sharanjeetsinghmago/LowPowerNFCBasedPhoneCover/Datasheets/NFC/OM5569_322E.png

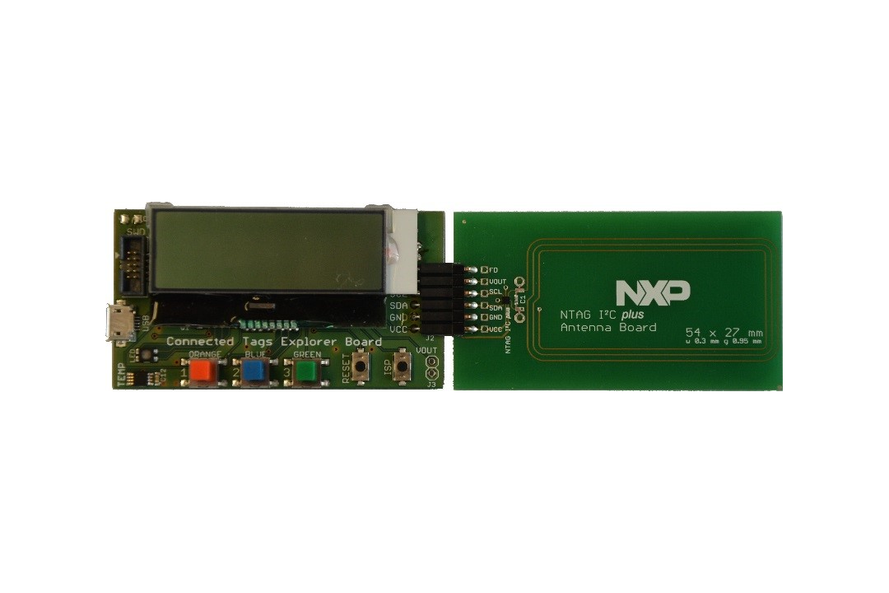
Datasheets/NFC/OM5569_322E.png
