sharanjeetsinghmago/LowPowerNFCBasedPhoneCover/phone_cover_pcb_files/DFM_Result.pdf

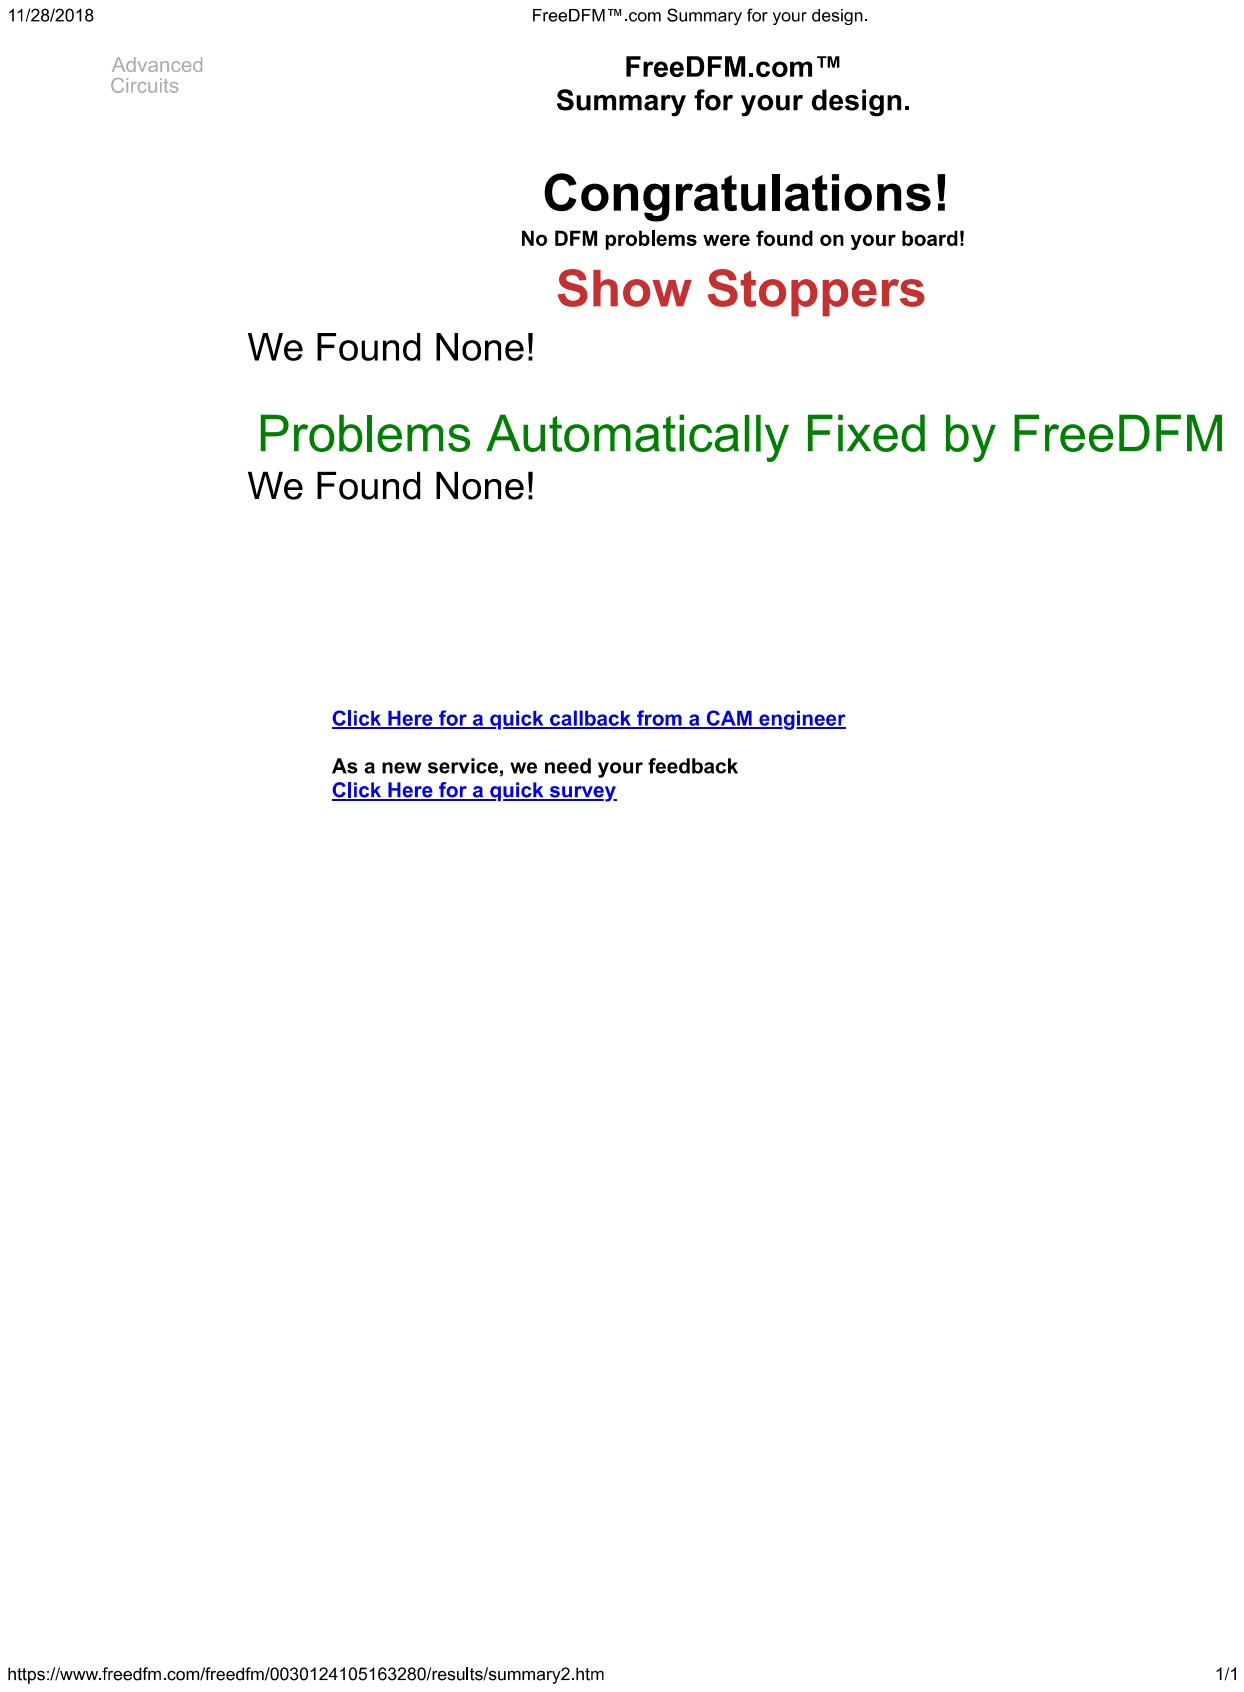
[picture p14: page 1]
