sharanjeetsinghmago/LowPowerNFCBasedPhoneCover/(list of files, drawings)

Other design files:
phone_cover_pcb_files/BQ25570RGRR.PcbLib
phone_cover_pcb_files/MCU.SchDoc
phone_cover_pcb_files/Peripherals.SchDoc
phone_cover_pcb_files/phone_cover.PrjPcb
phone_cover_pcb_files/phone_cover_layout.PcbDoc
phone_cover_pcb_files/phone_cover_parts.SchLib
phone_cover_pcb_files/Power.SchDoc
phone_cover_pcb_files/QFN-64.PcbLib
phone_cover_pcb_files/USB_Connector.PcbLib
