sharanjeetsinghmago/LowPowerNFCBasedPhoneCover/Verification Report.xlsx

To be verified | Definition of passing | Date test performed | Tested by | Measured result | Passed?
Power: Verify battery power supply | Check if the output voltage is within the maximum and minimum range of the battery | 2018-11-28 | Sharanjeet Singh Mago | Battery gave 3.8V output | Yes
Power: Verify NFC power supply | Typically, 5 mA at 2 V on the VOUT pin with an NFC Phone. | 2018-11-28 | Sharanjeet Singh Mago | NFC gives 3.3V output | Yes
Power: Verify USB Power Supply | Voltage level around 5V (Max 5.1V) | 2018-11-28 | Sharanjeet Singh Mago | USB gives 4.9-5V | Yes
PMU: Verify Output from PMU | Plug in the jumper to connect the USB output to input of PMU, Check for output voltage level of 3V | 2018-11-28 | Sharanjeet Singh Mago | PMU gives 3V | Yes
PMU: Verify if battery is charging using NFC | Plug in the jumper to connect NFC output to input of PMU, Check for rise in battery voltage | 2018-12-03 | Sharanjeet Singh Mago | When battery is not connected, the voltage at the terminals is 4V | Yes
PMU: Verify if battery is charging using USB | Plug in the jumper to connect USB output to input of PMU, Check for rise in battery voltage | 2018-12-03 | Sharanjeet Singh Mago | When battery is not connected, the voltage at the terminals is 4V | Yes
PMU: Verify system receiving power good and booting as energy storage element goes from too low of charge to enough charge | Connect an external power supply to instead of the battery and increase the voltage from starting from 0V. As the voltage level crosses VBAT_OK_HYST (3.8V) check for the VBAT_OK signal going from low to high |  |  |  | No
PMU: Verify system shutting off as energy storage element goes from enough charge to too low | Connect an external power supply to instead of the battery and increase the voltage from starting from 0V. As the voltage level crosses VBAT_OK_PROG (3.6V) check for the VBAT_OK signal going from high to low |  |  |  | No
Touch Sensors: Touch Sensors providing correct values to MCU/SoC | Connect the touch sensor breakout boards and tap on the touch pads to toggle the output (and LEDs). | 2018-12-05 | Sharanjeet Singh Mago | GPIO Pins read 3V and 0V when toggled | Yes
NFC: Verify communication using NFC radio with development kit | Check for transmitted and received data using development kit | 2018-12-08 | Sharanjeet Singh Mago | The same data is transmitted and read | Yes
NFC: Verify communication using NFC radio with MCU | Check for transmitted and received data to be same | 2018-12-08 | Sharanjeet Singh Mago | The same data is transmitted and read | Yes
MCU: Verify if the MCU is working properly | Write a code for giving high or low signals to any GPIO pins and check the signal using the LEDs | 2018-12-05 | Sharanjeet Singh Mago | LED glows when giving high output | Yes
MCU: Verify the working of crystal oscillators | Write a code to toggle the output of a GPIO pin high or low after every 500ms and check using the LEDs | 2018-12-05 | Sharanjeet Singh Mago | LED Blinking works fine | Yes
Firmware: Verify the working of I2C communication | Check for the transmitted and received data to be the same. | 2018-12-12 | Sharanjeet Singh Mago | The same data is transmitted and read | Yes
