sharanjeetsinghmago/LowPowerNFCBasedPhoneCover/(commit log)

2020-03-07 PCB files
    [BQ25570RGRR.PcbLib, MCU.SchDoc, Peripherals.SchDoc, Power.SchDoc, QFN-64.PcbLib, USB_Connector.PcbLib, phone_cover.PrjPcb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]
2020-03-07 verification report
    [Verification Report.xlsx]
